luoyx257/smart_fan_stm32/USER_PROTOCOL.md

# 智能小风扇 —— 通信协议与接线规格

本文档是**你配置上位机（TJC 串口屏 / 手机蓝牙 APP / SU-03T 语音模块）的唯一依据**，
单片机侧的解析代码已按本文实现完毕，地址如下：

| 用途 | 文件 |
|---|---|
| 串口屏解析/上报 | `Core/App/Src/app_ui.c` |
| 蓝牙解析 | `Core/App/Src/app_bt.c` |
| 语音解析 | `Core/App/Src/app_voice.c` |
| 命令码汇总 | `Core/App/Inc/cmd.h` |

---

## 0. 接线与串口参数（已核对，与你给的引脚表一致）

| 功能 | STM32 引脚 | 外设 | 波特率 | 备注 |
|---|---|---|---|---|
| 舵机 PWM | PA8 | TIM1_CH1 | 50Hz | 脉宽 500~2500us |
| 语音模块 | PA9 / PA10 | USART1 TX / RX | 9600 | 接 SU-03T 的 RX / TX（交叉） |
| 风扇调速 | PB5 | TIM3_CH2 | 20kHz | TB6612 PWMA |
| OLED | PB6 / PB7 | I2C1 SCL / SDA | 100kHz | SSD1306，地址 0x3C 或 0x3D，代码会自动探测 |
| 蜂鸣器 | PB8 | GPIO 输出 | — | **低电平发声**（MH-FMD 模块） |
| 蓝牙 | PB10 / PB11 | USART3 TX / RX | 9600 | 接 HC-05 的 RX / TX（交叉） |
| 电机方向 | PB0 / PB1 | GPIO 输出 | — | AIN1 / AIN2（正转：PB0=1, PB1=0） |
| 压力传感器 DO | PA5 | GPIO 输入（内部上拉） | — | 数字量判据，阈值用电位器调 |
| 压力传感器 AO | PA4 | ADC1_IN4 | — | 只用于显示原始值 |
| 串口屏 | PA2 / PA3 | USART2 TX / RX | 115200 | 交叉接屏的 RX / TX |
| 温湿度 | PA1 | GPIO 单总线 | — | DHT11，代码会动态切输出/输入 |
| 人体红外 | PA0 | GPIO 输入（内部上拉） | — | HC-SR501，高电平为检测到人 |
| 舵机电源 | — | 独立 5~6V | — | **必须共地**，详见第 5 节 |

---

## 1. 串口屏（TJC4827X243_011C，USART2 @ 115200）

### 1.1 屏幕 → 单片机：命令帧格式

```
'@'  CMD(1 个 ASCII 字符)  [VALUE(十进制数字, 可选)]
```

* 帧尾可以是 `\n`、`\r` 或 `0xFF`，代码三种都认；也支持用 `,` 分隔多个参数。
* 命令字符区分大小写：**0~9 和 A~F 表示功能，大写字母**。

### 1.2 命令码表（在 TJC 上位机里填到按钮的"触摸按下事件"）

| 命令码 | 功能 | 需要带参数 | TJC 里填的代码 |
|---|---|---|---|
| `0` | 打开风扇 | 否 | `printh 40 30 0D 0A` |
| `1` | 关闭风扇 | 否 | `printh 40 31 0D 0A` |
| `2` | 切到**手动**模式 | 否 | `printh 40 32 0D 0A` |
| `3` | 切到**自动**模式 | 否 | `printh 40 33 0D 0A` |
| `4` | 直接设定档位 0~5 | 是 | `printh 40 34 XXXX 0D 0A` |
| `5` | 设定温度阈值 10~45 | 是 | `printh 40 35 XXXX 0D 0A` |
| `6` | 设定倒计时（**秒**，0=取消） | 是 | `printh 40 36 XXXX 0D 0A` |
| `7` | 开始摇头 | 否 | `printh 40 37 0D 0A` |
| `8` | 停止摇头 | 否 | `printh 40 38 0D 0A` |
| `9` | 档位 +1 | 否 | `printh 40 39 0D 0A` |
| `A` | 档位 −1 | 否 | `printh 40 41 0D 0A` |
| `B` | 模式切换 | 否 | `printh 40 42 0D 0A` |
| `C` | 摇头开关切换 | 否 | `printh 40 43 0D 0A` |
| `D` | 风扇开关切换 | 否 | `printh 40 44 0D 0A` |
| `E` | 取消倒计时 | 否 | `printh 40 45 0D 0A` |
| `F` | 请求立即上报一次状态 | 否 | `printh 40 46 0D 0A` |

> `printh` 后面是**十六进制字节**。`40` = `'@'`，`0D 0A` = 回车换行。
> 带参数的（如 `4`/`5`/`6`）用 `printh` 拼四位数字比较麻烦，
> **更推荐用 `prints` + 数字控件组合**，见 1.4 节的示例。

### 1.3 单片机 → 屏幕：控件名约定

代码会写下面这些控件，**你必须在 TJC 工程里建好同名控件**，否则屏上不会变化：

| 控件名 | 类型 | 内容 | 说明 |
|---|---|---|---|
| `t0` | 数字控件 | 当前**温度** ℃ | 无有效读数时显示上一次的值 |
| `t1` | 数字控件 | 当前**湿度** % | |
| `t2` | 文本控件 | 模式 `AUTO` / `MANU` | |
| `t3` | 数字控件 | 当前**档位** 0~5 | |
| `t4` | 数字控件 | 倒计时**剩余秒数** | 未启用时为 0 |
| `t5` | 文本控件 | 摇头 `ON` / `OFF` | |
| `t6` | 数字控件 | 当前**温度阈值** | |
| `t7` | 文本控件 | 风扇 `ON` / `OFF` | |

上报节奏：
* 状态发生变化的 **150ms 后**上报一次关键项；
* 每 **5 秒**做一次整体刷新（含阈值 `t6`）。

### 1.4 TJC 里写"带参数命令"的推荐做法（滑块/数字控件）

假设你放了一个滑块叫 `h0`（范围 0~5，用来调档位），想让"松手"时下发 `@4<数值>`。
TJC 的 `printh` 不能直接插入变量，所以用 `prints` 拼字符串再发：

```
// h0 的"触摸释放事件"
printh 40 34
prints h0.val,0
printh 0D 0A
```

* `printh 40 34` 先发 `'@'` 和 `'4'`
* `prints h0.val,0` 把滑块数值当作**十进制字符串**发出去（`,0` 表示十进制）
* `printh 0D 0A` 发结束符

温度阈值（命令码 `5`）和倒计时（命令码 `6`）同理，把 `34` 换成 `35` / `36` 即可。

> 倒计时注意单位是**秒**。如果你想用分钟输入，就把控件值乘 60 再发，
> 或者告诉我，我把单片机侧改成按分钟解析。

---

## 2. 蓝牙（HC-05，USART3 @ 9600）—— 文本行协议

手机装任意"蓝牙串口助手"（推荐安卓的 *Serial Bluetooth Terminal*），
连上 HC-05 后直接发下面这些**文本命令**，每条以换行结尾。
命令**大小写不敏感**。

| 命令 | 功能 |
|---|---|
| `ON` | 开风扇 |
| `OFF` | 关风扇（同时关摇头、退出倒计时） |
| `AUTO` | 自动模式 |
| `MANUAL` | 手动模式 |
| `MODE` | 模式切换 |
| `L+` / `L-` | 档位 +1 / −1 |
| `LV0` ~ `LV5` | 直接设定档位 |
| `TH20` | 温度阈值设为 20（10~45，超范围自动夹紧） |
| `TIME300` | 倒计时 300 秒（`TIME0` 等于取消） |
| `TCANCEL` | 取消倒计时 |
| `SWING` / `NOSWING` | 摇头开 / 关 |
| `SW` | 摇头切换 |
| `STATUS` | 请求上报一次状态 |

每收到一条命令，单片机都会回一行 `ACK:xxx`；无法识别则回 `ERR`。
**在手机 APP 上看到 `ACK` 就说明接线和波特率都是对的**——这是最方便的联调手段。

> 如果你打算自己写安卓 APP，也可以直接照抄这个文本协议，很省事。

---

## 3. 语音（SU-03T，USART1 @ 9600）—— 二进制帧协议

### 3.1 帧格式（固定 5 字节）

```
0xAA  0x55  CMD  VALUE  XOR
```

| 字节 | 含义 |
|---|---|
| `0xAA` | 帧头 1 |
| `0x55` | 帧头 2 |
| `CMD` | 命令码，见 3.2 表 |
| `VALUE` | 参数；不需要参数的填 `0x00` |
| `XOR` | 前 4 字节异或校验：`0xAA ^ 0x55 ^ CMD ^ VALUE` |

示例：`打开风扇` = `AA 55 01 00 FE`
计算：`AA ^ 55 = FF`，`FF ^ 01 = FE`，`FE ^ 00 = FE` ✔

### 3.2 命令码表（在 SU-03T 的词条里逐条填"串口输出"）

| CMD | 功能 | VALUE | 完整帧（十六进制） |
|---|---|---|---|
| `0x01` | 打开风扇 | 0 | `AA 55 01 00 FE` |
| `0x02` | 关闭风扇 | 0 | `AA 55 02 00 FD` |
| `0x03` | 自动模式 | 0 | `AA 55 03 00 FC` |
| `0x04` | 手动模式 | 0 | `AA 55 04 00 FB` |
| `0x05` | 切换模式 | 0 | `AA 55 05 00 FA` |
| `0x06` | 调高一档 | 0 | `AA 55 06 00 F9` |
| `0x07` | 调低一档 | 0 | `AA 55 07 00 F8` |
| `0x08` | 设置到第 N 档 | N (0~5) | `AA 55 08 N (FD^N)` |
| `0x09` | 温度阈值设为 N | N (10~45) | `AA 55 09 N (FC^N)` |
| `0x0A` | 阈值 +1 | 0 | `AA 55 0A 00 F5` |
| `0x0B` | 阈值 −1 | 0 | `AA 55 0B 00 F4` |
| `0x0C` | 倒计时 N **分钟** | N | `AA 55 0C N (F3^N)` |
| `0x0D` | 取消倒计时 | 0 | `AA 55 0D 00 F2` |
| `0x0E` | 开始摇头 | 0 | `AA 55 0E 00 F1` |
| `0x0F` | 停止摇头 | 0 | `AA 55 0F 00 F0` |
| `0x10` | 摇头切换 | 0 | `AA 55 10 00 EF` |
| `0x11` | 上报当前状态 | 0 | `AA 55 11 00 EE` |
| `0x12` | 查询是否正在恒温调速 | 0 | `AA 55 12 00 ED` |

### 3.3 建议的 17 个词条（照着录就行）

```
小风扇打开 / 打开风扇      -> AA 55 01 00 FE
小风扇关闭 / 关闭风扇      -> AA 55 02 00 FD
自动模式                   -> AA 55 03 00 FC
手动模式                   -> AA 55 04 00 FB
切换模式                   -> AA 55 05 00 FA
调高一档 / 风大一点        -> AA 55 06 00 F9
调低一档 / 风小一点        -> AA 55 07 00 F8
设置到一档                 -> AA 55 08 01 FD
设置到三档                 -> AA 55 08 03 FF
设置到五档                 -> AA 55 08 05 F9
温度阈值二十五度            -> AA 55 09 19 E5      (0xFC^0x19 = 0xE5)
温度阈值三十度              -> AA 55 09 1E E2
阈值高一点                 -> AA 55 0A 00 F5
阈值低一点                 -> AA 55 0B 00 F4
倒计时十分钟               -> AA 55 0C 0A F9      (0xF3^0x0A = 0xF9)
开始摇头                   -> AA 55 0E 00 F1
停止摇头                   -> AA 55 0F 00 F0
```

> 语音模块到货后如果它的输出格式跟这里不一样（比如只能输出固定字符串），
> 把实际输出格式发我，我改 `app_voice.c` 的解析部分就行，其它都不用动。

---

## 4. 各模式行为约定（和你要的完全对齐）

### 4.1 手动模式
* 风扇开关、档位完全听串口屏 / 蓝牙 / 语音的。
* 档位 1~5 对应占空比 **40% / 55% / 70% / 85% / 100%**。
* 档位到 5 后再按"+"保持 5，不循环。
* 0 档即停止。

### 4.2 自动模式（含增量式 PID 恒温调速）

**开风扇条件**：`(人体红外有人 或 压力传感器判定坐下)` **且** `当前温度 > 阈值`
→ 风扇从 1 档起步，启动 **PID 恒温调速**，并开始蜂鸣报警。

**PID 恒温调速**：

| 项目 | 取值 | 说明 |
|---|---|---|
| 算法 | **增量式 PID** | Δu = Kp·(e[k]−e[k−1]) + Ki·e[k] + Kd·(e[k]−2e[k−1]+e[k−2]) |
| 设定值 | 当前温度阈值（`t6` / `TH` 可调） | 阈值既是启动条件，也是控制目标 |
| 被控量 | DHT11 温度 | 采样周期 2s（DHT11 硬件上限） |
| 输出 | 风扇档位 1~5 | 限幅在 1~5，PID 不负责关机 |
| 运算周期 | **10s** | 温控对象时间常数在分钟级，取 1/10~1/5 |
| Kp / Ki / Kd | 0.30 / 0.12 / 0.04 | 见 `app_state.h` 的 `PID_KP` 等宏 |
| 死区 | **±0.5℃** | DHT11 只有 1℃ 分辨率，无死区会稳态抖动 |
| 积分为何不饱和 | 增量式结构天然抗饱和 | 积分作用体现在已限幅的 u[k−1] 上 |

**为什么用增量式而不是位置式**（面试常问）：
1. 温控是大惯性对象，增量式输出"增量"，不会因积分瞬间累积把执行器一次打到极限；
2. 执行器是离散档位（1~5），增量式天然适合；
3. 不需要保存历史积分项，RAM 开销小，也不需要额外的抗饱和逻辑。

**⚠️ 传感器位置要求**：DHT11 **必须远离风扇出风口**。
PID 要求负反馈——测的必须是环境温度。若 DHT11 在风口，风扇一转测到的温度反而更低，
PID 会判断"还不够冷"而继续加档，最后饱和到 5 档并永远收敛不了。
这是**正反馈**导致的，不是代码问题。

**关风扇条件**（任一满足）：
1. 人离开（红外无人 **且** 压力无）**持续 30 秒**；
2. 温度降到 `阈值 − 2℃` 以下（2℃ 回差，避免临界点反复开关）。
→ 关闭时同时退出 PID，并复位 PID 历史误差（下次进入不会带旧数据）。

**其它保护**：
* DHT11 读数失败时**不会**因为"温度=0"误关风扇，也不会让 PID 瞎调；
* 自动模式下人工按"档位 +/−"（或发 `LVn`）会**把 PID 输出对齐到该档位**，
  避免下一次 PID 运算又把它跳回去；
* 切模式 / 关风扇会复位 PID 状态。

### 4.3 蜂鸣器报警
* 只在自动模式且风扇在转时报警。
* 节奏：**响 200ms → 停 1.8s** 循环。
* 报警累计 **30 秒后自动静音**（不会一直吵）。

### 4.4 倒计时
* 时间到：**关风扇 + 关摇头 + 舵机回中位**（按你的要求"都关"）。
* 手动关风扇也会同时取消倒计时，避免出现"风扇停了但倒计时还在跑"。
* 设置倒计时会自动把风扇开起来。

### 4.5 摇头
* 非阻塞状态机，不影响其它功能：
  `左 45°（停 1.2s）→ 中位（停 0.3s）→ 右 225°（停 1.2s）→ 中位 → 循环`
* 关闭摇头时舵机回中位。

---

## 5. 硬件必须注意的 3 件事

### 5.1 舵机必须独立供电 ★最重要
维特 P20 舵机堵转电流 **1.0~2.3A**，空载 0.3~0.8A。
STM32 蓝板的 5V 引脚来自 USB，整口只有 500mA，**绝对带不动**。

* 舵机 VCC 接**独立 5~6V 电源**（≥3A 最稳，2A 也能凑合）；
* 舵机 GND **必须和单片机 GND 共地**；
* 舵机信号线接 PA8 直连即可（信号电流很小，共地后没问题）。

不这么接的典型现象：舵机一动 → 5V 掉压 → 单片机复位 / OLED 花屏 / 蓝牙掉线。

### 5.2 DHT11 上拉
你买的是三脚集成模块，模块自带上拉电阻，直接接 PA1 / 5V / GND 就行。
如果读不到数据，先量一下 DATA 对 VCC 之间是否有 4.7k~10k 电阻。

### 5.3 压力传感器方向
代码默认 **DO 输出高电平 = 判定坐下**。
如果你的模块是低电平有效（坐下时 DO 变低），告诉我一声，改一行就行
（`Core/Bsp/Src/bsp_sensor.c` 的 `Sensor_PressureDoActive()`）。

---

## 6. 怎么快速判断有没有跑起来

按这个顺序测，每步都有明确的"成功现象"：

| 步骤 | 操作 | 成功现象 | 失败说明 |
|---|---|---|---|
| 1 | 上电 | OLED 显示 4 行内容 | 全黑 → OLED 地址/接线问题（代码会自动试 0x3C 和 0x3D） |
| 2 | 手机连 HC-05，发 `STATUS` | 收到 `ACK:STATUS` | 没回复 → 检查 USART3 交叉接线和 9600 波特率 |
| 3 | 发 `ON` 然后 `L+` | 风扇转起来，档位递增，OLED 档位跟着变 | 只转不调速 → PWMA/PB5 接线 |
| 4 | 发 `SWING` | 舵机开始左右摆头 | 不动 → 先查舵机独立电源和共地，再看 PA8 |
| 5 | 发 `AUTO`，用手靠近红外 | 风扇开 + 蜂鸣器滴滴响 | 不响应 → 红外模块需 1 分钟预热，属正常 |
| 6 | 串口屏上点按钮 | 屏上数值实时更新 | 不动 → 核对 1.3 节的控件名是否一致 |
| 7 | 发 `TIME10` | 屏/OLED 显示倒计时递减，到点全关 | — |

---

## 7. 代码结构（方便你自己改）

```
Core/
├── App/
│   ├── Inc/  app_state.h cmd.h app_fan.h app_sensor.h app_oled.h app_ui.h app_bt.h app_voice.h
│   └── Src/  app_state.c cmd.c app_fan.c app_sensor.c app_oled.c app_ui.c app_bt.c app_voice.c
├── Bsp/
│   ├── Inc/  bsp_delay.h bsp_dht11.h bsp_sensor.h bsp_fan.h bsp_servo.h bsp_buzzer.h bsp_pid.h
│   │         oled_font.h bsp_oled.h bsp_uart.h bsp_screen.h
│   └── Src/  bsp_delay.c bsp_dht11.c bsp_sensor.c bsp_fan.c bsp_servo.c bsp_buzzer.c bsp_pid.c
│             oled_font.c bsp_oled.c bsp_uart.c bsp_screen.c
└── Src/      freertos.c（已改成调用 App 层任务函数）
```

需要调参数全在 **`Core/App/Inc/app_state.h`** 顶部的宏里（阈值、档位映射、
摇头角度、报警节奏、去抖时间等），改完重新编译即可。

---

## 8. 当前资源占用（已实测编译）

```
Program Size: Code=28796  RO-data=3864  RW-data=272  ZI-data=15400
```

| 项目 | 占用 | 上限 | 余量 |
|---|---|---|---|
| Flash | 32932 B | 65536 B | 50.3% |
| RAM | 15672 B | 20480 B | 23.5%（还有 4.8KB） |

其中 FreeRTOS 堆已从 CubeMX 默认的 3072 B 调到 **8192 B**
（原值会让任务创建失败并卡死在 `configASSERT`，这是个必踩的坑）。
