luoyx257/smart_fan_stm32/hardware/BOM_Board1_PCB1_2026-09-28.xlsx

No. | Quantity | Comment | Designator | Footprint | Value | Manufacturer Part | Manufacturer | Supplier Part | Supplier
1 | 1 | 10nF | C1 | C0603 | 10nF | FCC0603B103K500CT | FOJAN(富捷) | C5137477 | LCSC
2 | 1 | 22uF | C2 | CAP-TH_BD10.0-P5.00-D0.6-FD | 22uF | PA160V22M10X13 | JIERR(捷而瑞) | C48935343 | LCSC
3 | 1 | 3.9nF | C3 | C0805 | 3.9nF | GRM2165C1H392JA01D | muRata(村田) | C97901 | LCSC
4 | 1 | 100nF | C4 | C0603 | 100nF | FCC0603B104K500CT | FOJAN(富捷) | C5137636 | LCSC
5 | 1 | 10uF | C5 | CAP-SMD_BD5.0-L5.3-W5.3-LS6.0-FD | 10uF | JVJ50v10M5x5 | JIERR(捷而瑞) | C46550416 | LCSC
6 | 1 | HX PM2.54-1x7P ZC-Y | CN1 | HDR-TH_7P-P2.54-V-F |  | HX PM2.54-1x7P ZC-Y | hanxia(韩下) | C22438157 | LCSC
7 | 2 | LAIL-PTB3.81-2P-GN-02S-ZC | CN2,CN3 | CONN-TH_LAIL-PTB3.81-2P-GN-02S-ZC |  | LAIL-PTB3.81-2P-GN-02S-ZC | LAILAN(莱联) | C55144765 | LCSC
8 | 1 | PH2.0-4P | CN4 | CONN-TH_PH2.0-4P |  | PH2.0-4P | CAX(创都) | C722763 | LCSC
9 | 1 | HX PZ2.54-1x3P ZZ | H1 | CONN-TH_HX-PZ2.54-1X3P-ZZ |  | HX PZ2.54-1x3P ZZ | hanxia(韩下) | C32713269 | LCSC
10 | 1 | 2.54-1*4P母 | H2 | HDR-TH_4P-P2.54-V-F |  | 2.54-1*4P母 | BOOMELE(博穆精密) | C2718488 | LCSC
11 | 1 | 10uH | L2 | IND-SMD_L6.0-W6.0_LPS6225 | 10uH | PNR6045-100-M | JIERR(捷而瑞) | C55381773 | LCSC
12 | 1 | MHL4230LRTD | LED1 | LED-TH_BD4.8-P2.54-FD_RED |  | MHL4230LRTD | MEIHUA(美华) | C7470871 | LCSC
13 | 2 | 2.54-1*8P母环保 | P1,P2 | HDR-TH_8P-P2.54-V-F |  | 2.54-1*8P母环保 | BOOMELE(博穆精密) | C27438 | LCSC
14 | 1 | 2.54-1*6P母 | P3 | HDR-TH_6P-P2.54-V-F |  | 2.54-1*6P母 | BOOMELE(博穆精密) | C40877 | LCSC
15 | 1 | AO3401 | Q1 | SOT-23-3_L2.9-W1.4-P1.90-LS2.6-BR |  | AO3401 | TWGMC(迪嘉) | C727156 | LCSC
16 | 1 | 44.2kΩ | R1 | R0402 | 44.2kΩ | FRC0402F4422TS | FOJAN(富捷) | C2933098 | LCSC
17 | 1 | 10kΩ | R3 | R0805 | 10kΩ | RT0805BRD0710KL | YAGEO(国巨) | C110775 | LCSC
18 | 1 | 1kΩ | R4 | R0805 | 1kΩ | RT0805BRD071KL | YAGEO(国巨) | C110774 | LCSC
19 | 1 | 150Ω | R5 | RES-TH_BD4.5-L11.5-P15.50-D0.8 | 150Ω | MFR2WSFTE73-150R | YAGEO(国巨) | C173070 | LCSC
20 | 1 | 10kΩ | R6 | R0402 | 10kΩ | FRC0402F1002TS | FOJAN(富捷) | C2906861 | LCSC
21 | 1 | 100kΩ | R7 | R0402 | 100kΩ | FRC0402F1003TS | FOJAN(富捷) | C2906859 | LCSC
22 | 2 | KH-2.54FH-1X20P-H8.5 | U1,U2 | HDR-TH_20P-P2.54-V-F-2 |  | KH-2.54FH-1X20P-H8.5 | kinghelm(金航标) | C2905423 | LCSC
23 | 2 | KH-2.54FH-1X11P-H8.5 | U3,U4 | HDR-TH_11P-P2.54-V-F |  | KH-2.54FH-1X11P-H8.5 | kinghelm(金航标) | C2932674 | LCSC
24 | 1 | DHT11 | U5 | SENSOR-TH_DHT11 |  | DHT11 | 广州奥松 | C117051 | LCSC
25 | 3 | PM2.54-1*3 | U6,U7,U9 | HDR-TH_3P-P2.54-V-F |  | PM2.54-1*3 | ZHOURI(洲日) | C5116529 | LCSC
26 | 1 | MSMP2307DN-LF-Z | U8 | ESOP-8_L4.9-W3.9-P1.27-LS6.0-BL-EP |  | MSMP2307DN-LF-Z | MSKSEMI(美森科) | C49375228 | LCSC
