luoyx257/smart_fan_stm32/MDK-ARM/build_log.txt

*** Using Compiler 'V5.06 update 5 (build 528)', folder: 'D:\keil5\ARM\ARMCC\Bin'
Build target 'smart_fan'
assembling startup_stm32f103xb.s...
compiling i2c.c...
compiling gpio.c...
compiling main.c...
compiling stm32f1xx_it.c...
compiling freertos.c...
compiling usart.c...
compiling tim.c...
compiling adc.c...
compiling stm32f1xx_hal_gpio_ex.c...
compiling stm32f1xx_hal_timebase_tim.c...
compiling stm32f1xx_hal_msp.c...
compiling stm32f1xx_hal_tim_ex.c...
compiling stm32f1xx_hal_tim.c...
compiling stm32f1xx_hal_adc.c...
compiling stm32f1xx_hal_adc_ex.c...
compiling stm32f1xx_hal_cortex.c...
compiling stm32f1xx_hal_dma.c...
compiling stm32f1xx_hal_rcc_ex.c...
compiling stm32f1xx_hal_rcc.c...
compiling stm32f1xx_hal_flash.c...
compiling stm32f1xx_hal_exti.c...
compiling stm32f1xx_hal_pwr.c...
compiling stm32f1xx_hal.c...
compiling list.c...
compiling croutine.c...
compiling stm32f1xx_hal_gpio.c...
compiling event_groups.c...
compiling stm32f1xx_hal_flash_ex.c...
compiling stream_buffer.c...
compiling queue.c...
compiling timers.c...
compiling heap_4.c...
compiling tasks.c...
compiling app_state.c...
compiling cmd.c...
compiling app_sensor.c...
compiling app_fan.c...
compiling port.c...
compiling app_ui.c...
compiling app_oled.c...
compiling system_stm32f1xx.c...
compiling stm32f1xx_hal_uart.c...
compiling app_voice.c...
compiling oled_font.c...
compiling stm32f1xx_hal_i2c.c...
compiling bsp_pid.c...
compiling bsp_fan.c...
compiling bsp_delay.c...
compiling bsp_dht11.c...
compiling cmsis_os2.c...
compiling bsp_servo.c...
compiling app_bt.c...
compiling bsp_oled.c...
compiling bsp_sensor.c...
compiling bsp_buzzer.c...
compiling bsp_screen.c...
compiling bsp_uart.c...
linking...
Program Size: Code=28796 RO-data=3864 RW-data=272 ZI-data=15400  
FromELF: creating hex file...
"smart_fan\smart_fan.axf" - 0 Error(s), 0 Warning(s).
Build Time Elapsed:  00:00:08
