luoyx257/smart_fan_stm32/hardware/pdf.pdf

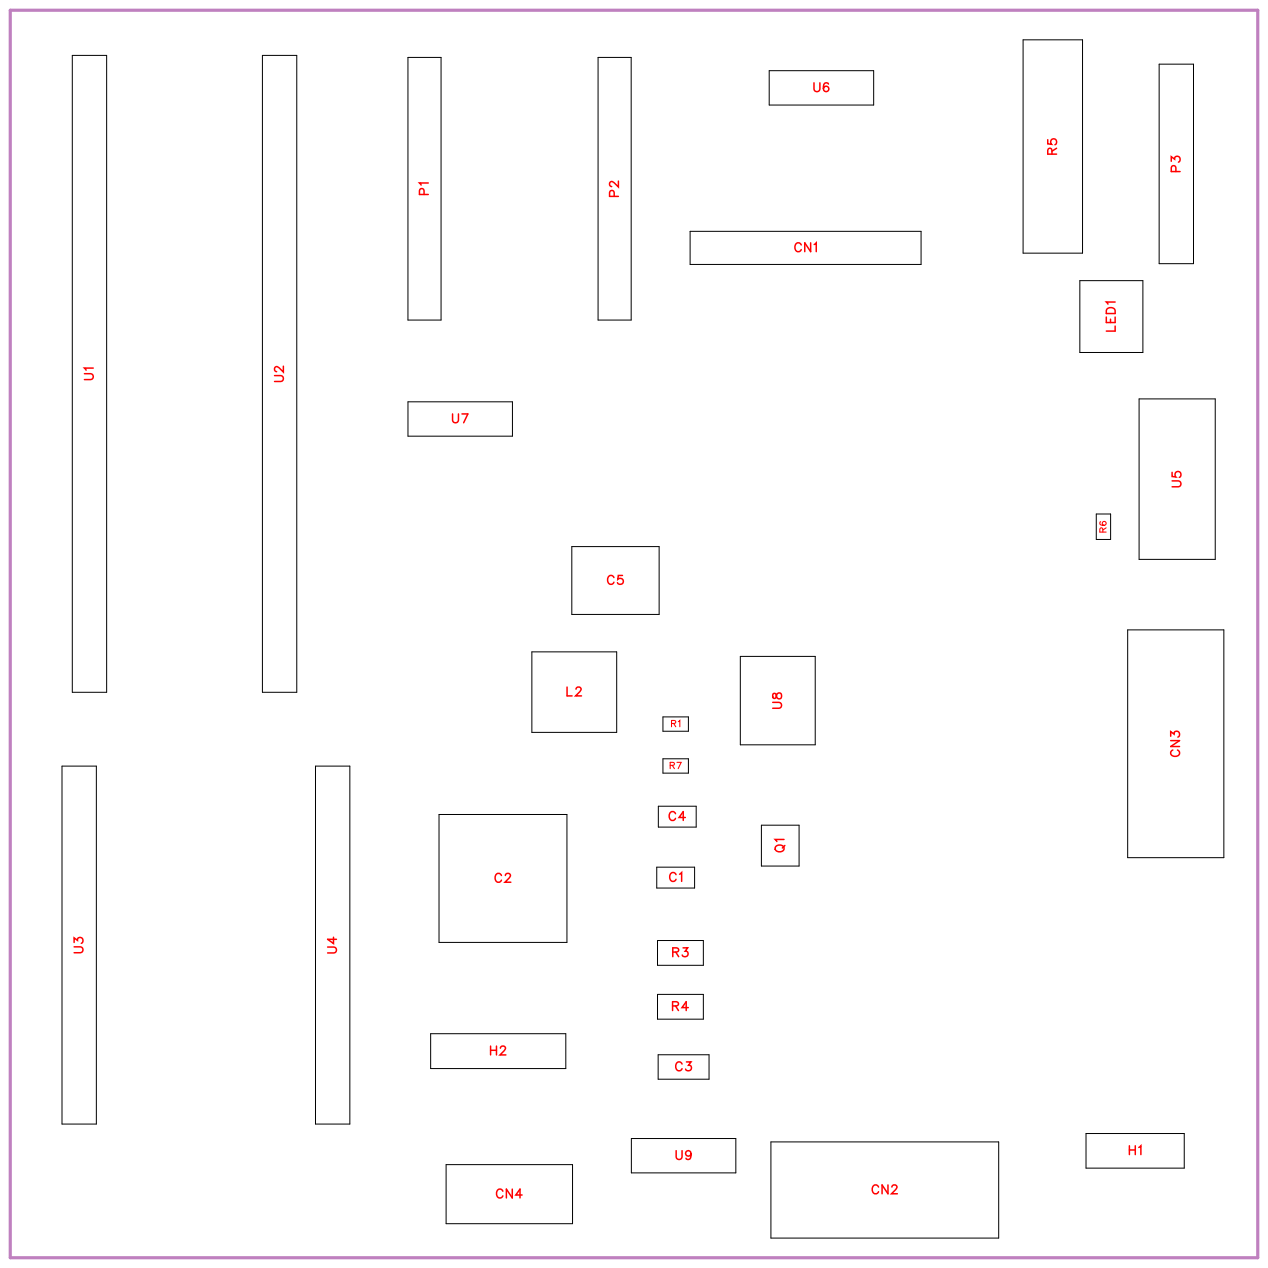
[picture p1: page 1]

No. | Quantity | Comment | Designator | Footprint | Value | Manufacture r Part | Manufacture r | Supplier Part | Supplier
1 | 1 | 10nF | C1 | C0603 | 10nF | FCC0603B103 K500CT | FOJAN(Ìw) | C5137477 | LCSC
2 | 1 | 22uF | C2 | CAP-TH_BD10 .0-P5.00-D0 .6-FD | 22uF | PA160V22M10 X13 | JIERR(w^) | C48935343 | LCSC
3 | 1 | 3.9nF | C3 | C0805 | 3.9nF | GRM2165C1H3 92JA01D | muRata(Q0) | C97901 | LCSC
4 | 1 | 100nF | C4 | C0603 | 100nF | FCC0603B104 K500CT | FOJAN(Ìw) | C5137636 | LCSC
5 | 1 | 10uF | C5 | CAP-SMD_BD5 .0-L5.3-W5. 3-LS6.0-FD | 10uF | JVJ50v10M5x 5 | JIERR(w^) | C46550416 | LCSC
6 | 1 | HX PM2.54-1x7P ZC-Y | CN1 | HDR-TH_7P-P 2.54-V-F | | HX PM2.54-1x7P ZC-Y | hanxia(é) | C22438157 | LCSC
7 | 2 | LAIL-PTB3.8 1-2P-GN-02S -ZC | CN2,CN3 | CONN-TH_LAI L-PTB3.81-2 P-GN-02S-ZC | | LAIL-PTB3.8 1-2P-GN-02S -ZC | LAILAN(±T) | C55144765 | LCSC
8 | 1 | PH2.0-4P | CN4 | CONN-TH_PH2 .0-4P | | PH2.0-4P | CAX(ý) | C722763 | LCSC
9 | 1 | HX PZ2.54-1x3P ZZ | H1 | CONN-TH_HX-PZ2.54-1X3P -ZZ | | HX PZ2.54-1x3P ZZ | hanxia(é) | C32713269 | LCSC
10 | 1 | 2.54-1*4PÍ | H2 | HDR-TH_4P-P 2.54-V-F | | 2.54-1*4PÍ | BOOMELE(ZF¾) Tj | T* (Æ) C2718488 | LCSC
11 | 1 | 10uH | L2 | IND-SMD_L6. 0-W6.0_LPS6 225 | 10uH | PNR6045-100 -M | JIERR(w^) | C55381773 | LCSC
12 | 1 | MHL4230LRTDLED1 | | LED-TH_BD4. 8-P2.54-FD_ RED | | MHL4230LRTDMEIHUA(ŽN) | | C7470871 | LCSC
13 | 2 | 2.54-1*8PÍ¯ Ý | P1,P2 | HDR-TH_8P-P 2.54-V-F | | 2.54-1*8PÍ¯ Ý | BOOMELE(ZF¾) Tj | T* (Æ) C27438 | LCSC
14 | 1 | 2.54-1*6PÍ | P3 | HDR-TH_6P-P 2.54-V-F | | 2.54-1*6PÍ | BOOMELE(ZF¾) Tj | T* (Æ) C40877 | LCSC
15 | 1 | AO3401 | Q1 | SOT-23-3_L2 .9-W1.4-P1. 90-LS2.6-BR | | AO3401 | TWGMC(ê ) | C727156 | LCSC
16 | 1 | 44.2k© | R1 | R0402 | 44.2k© | FRC0402F442 2TS | FOJAN(Ìw) | C2933098 | LCSC
17 | 1 | 10k© | R3 | R0805 | 10k© | RT0805BRD07 10KL | YAGEO(ýè) | C110775 | LCSC
18 | 1 | 1k© | R4 | R0805 | 1k© | RT0805BRD07 1KL | YAGEO(ýè) | C110774 | LCSC
19 | 1 | 150© | R5 | RES-TH_BD4. 5-L11.5-P15 .50-D0.8 | 150© | MFR2WSFTE73 -150R | YAGEO(ýè) | C173070 | LCSC

20 | 1 | 10k© | R6 | R0402 | 10k© | FRC0402F100 2TS | FOJAN(Ìw) | C2906861 | LCSC
21 | 1 | 100k© | R7 | R0402 | 100k© | FRC0402F100 3TS | FOJAN(Ìw) | C2906859 | LCSC
22 | 2 | KH-2.54FH-1 X20P-H8.5 | U1,U2 | HDR-TH_20P-P2.54-V-F-2 | | KH-2.54FH-1 X20P-H8.5 | kinghelm(Ñ*) Tj | T* () C2905423 | LCSC
23 | 2 | KH-2.54FH-1 X11P-H8.5 | U3,U4 | HDR-TH_11P-P2.54-V-F | | KH-2.54FH-1 X11P-H8.5 | kinghelm(Ñ*) Tj | T* () C2932674 | LCSC
24 | 1 | DHT11 | U5 | SENSOR-TH_D HT11 | | DHT11 | •Þe~ | C117051 | LCSC
25 | 3 | PM2.54-1*3 | U6,U7,U9 | HDR-TH_3P-P 2.54-V-F | | PM2.54-1*3 | ZHOURI(2å) | C5116529 | LCSC
26 | 1 | MSMP2307DN-LF-Z | U8 | ESOP-8_L4.9 -W3.9-P1.27 -LS6.0-BL-E P | | MSMP2307DN-LF-Z | MSKSEMI(ŽîÑ) Tj | T* () C49375228 | LCSC

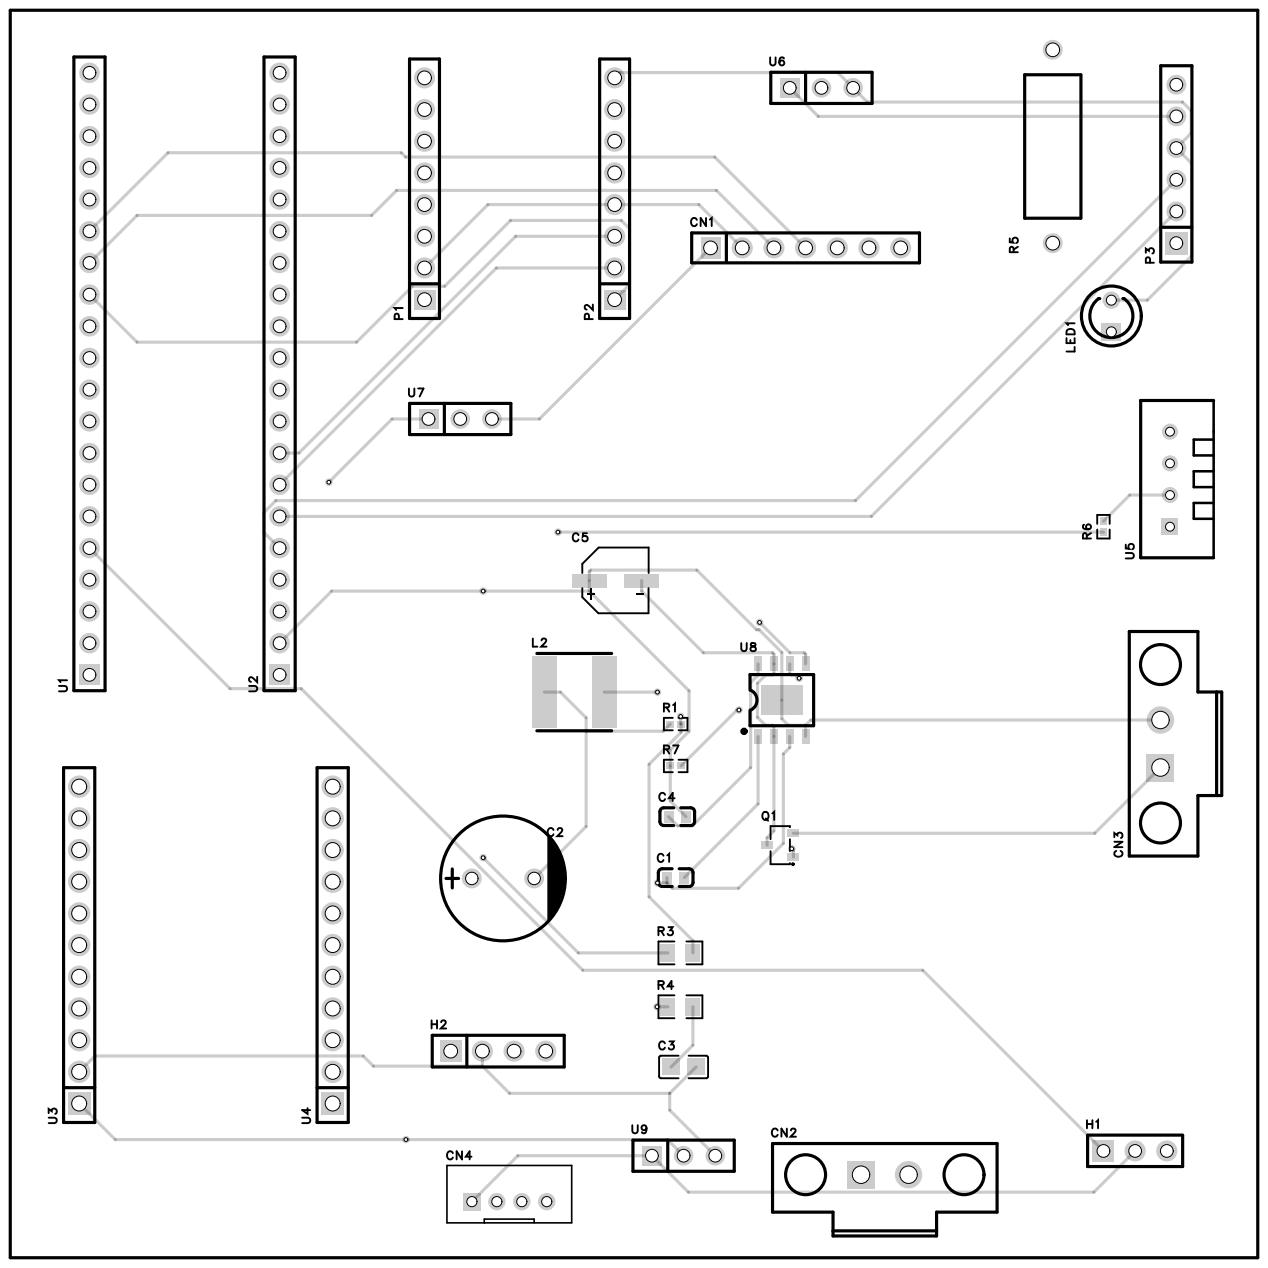
[picture p2: page 5]

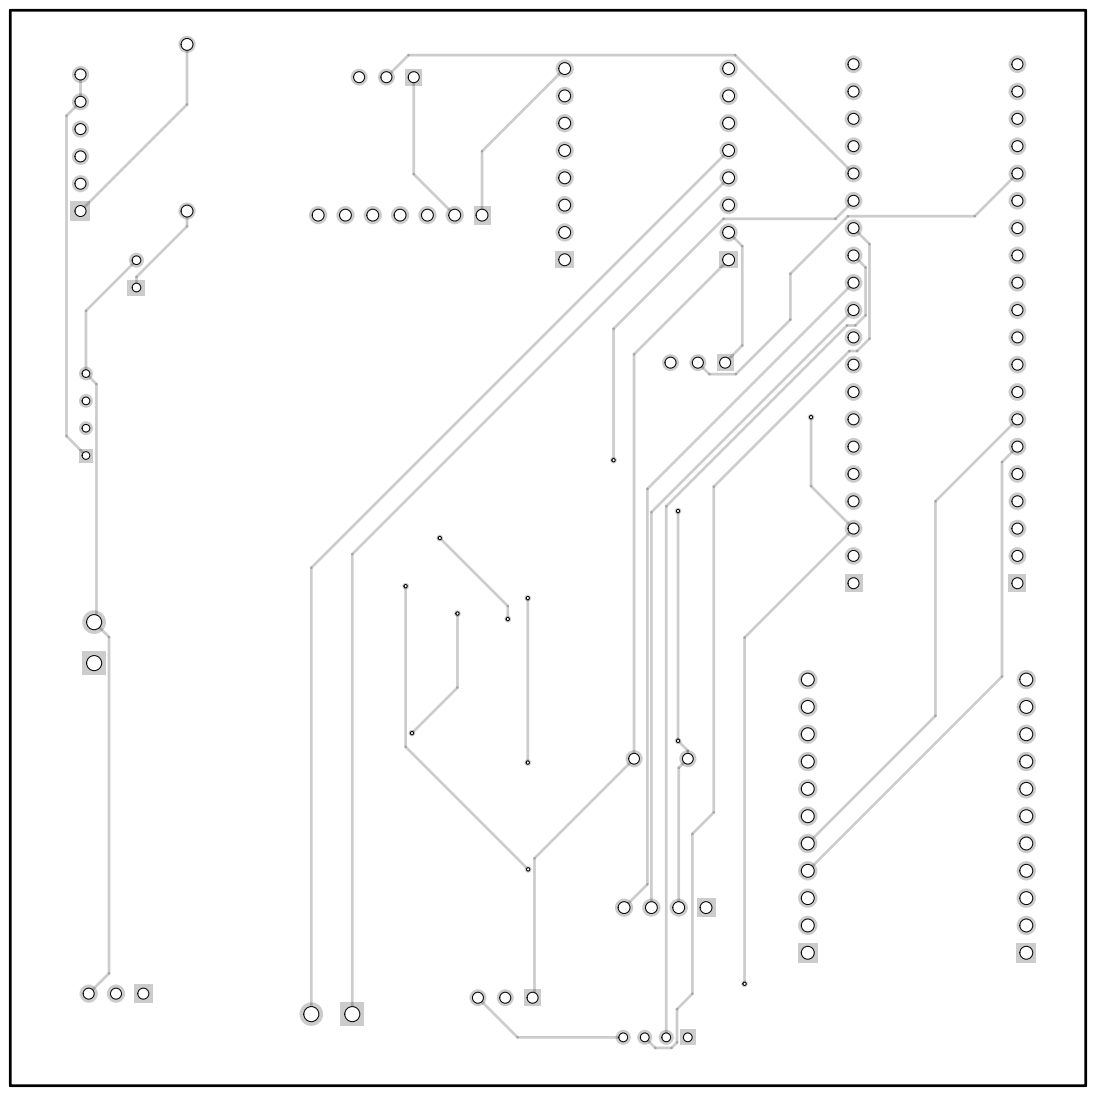
[picture p3: page 6]

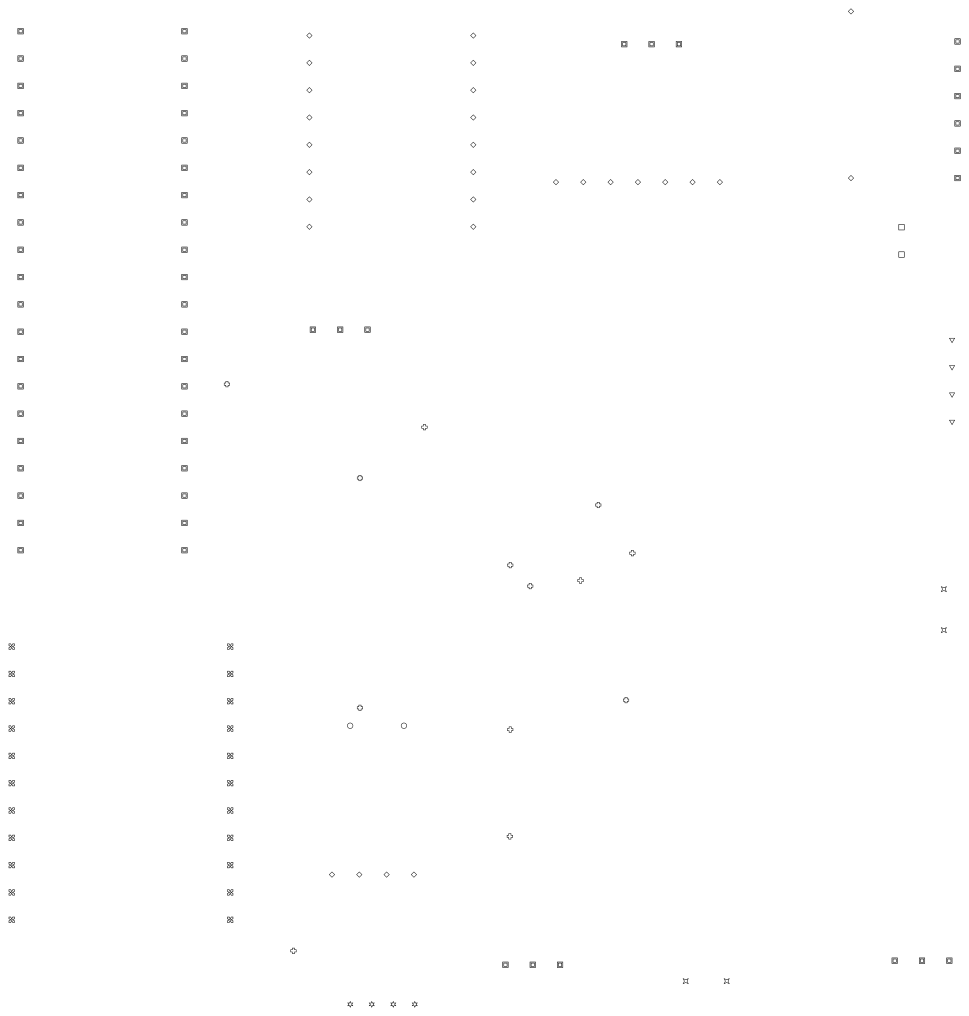
[picture p4: page 7]
