luoyx257/smart_fan_stm32/smart_fan.ioc

Mcu.UserName=STM32F103C8Tx
PA0-WKUP.Signal=GPIO_Input
PA1.Signal=GPIO_Input
PA10.Signal=USART1_RX
PA13.Signal=SYS_JTMS-SWDIO
PA14.Signal=SYS_JTCK-SWCLK
PA2.Signal=USART2_TX
PA3.Signal=USART2_RX
PA4.Signal=ADCx_IN4
PA5.Signal=GPIO_Input
PA8.Signal=S_TIM1_CH1
PA9.Signal=USART1_TX
PB0.Signal=GPIO_Output
PB1.Signal=GPIO_Output
PB10.Signal=USART3_TX
PB11.Signal=USART3_RX
PB5.Signal=S_TIM3_CH2
PB6.Signal=I2C1_SCL
PB7.Signal=I2C1_SDA
PB8.Signal=GPIO_Output
PD0-OSC_IN.Signal=RCC_OSC_IN
PD1-OSC_OUT.Signal=RCC_OSC_OUT
