luoyx257/smart_fan_stm32/Core/Bsp/Src/oled_font.c

/**
  ******************************************************************************
  * @file    oled_font.c
  * @brief   8x16 ASCII 点阵字库（字符 0x20~0x7E，共 95 个）
  * @note    点阵排列与 SSD1306 显存一致：每列 1 字节，低位在上（bit0 = 页内最上一行）。
  *          每个字符 16 列 x 2 页 = 32 字节：前 16 字节为上半（行 0~7），
  *          后 16 字节为下半（行 8~15）。
  *          本文件由工具自动生成，如需更换字体请重新生成，不要手改。
  ******************************************************************************
  */

/* Includes ------------------------------------------------------------------*/
#include "oled_font.h"

/* Private variables ---------------------------------------------------------*/
/* 字符 0x20（空格）到 0x7E（~）的 8x16 点阵 */
const uint8_t OLED_Font8x16[OLED_FONT_CHARS][OLED_FONT_BYTES_PER_CHAR] = {
    { 0x00,0x00,0x00,0x00,0x00,0x00,0x00,0x00,0x00,0x00,0x00,0x00,0x00,0x00,0x00,0x00 },   /* 0x20 */
    { 0x00,0x00,0x00,0x00,0x00,0xFE,0xFE,0x00,0x00,0x00,0x00,0x00,0x00,0x06,0x06,0x00 },   /* 0x21 */
    { 0x00,0x00,0x00,0x00,0x0E,0x02,0x00,0x0E,0x00,0x00,0x00,0x00,0x00,0x00,0x00,0x00 },   /* 0x22 */
    { 0x00,0x00,0x80,0x90,0xF8,0x9C,0x90,0xFC,0x00,0x00,0x00,0x00,0x07,0x00,0x06,0x07 },   /* 0x23 */
    { 0x00,0x00,0x00,0x38,0x3C,0xE4,0xFE,0xC4,0x00,0x00,0x00,0x04,0x04,0x1F,0x04,0x06 },   /* 0x24 */
    { 0x00,0x00,0x00,0x1E,0x12,0xDE,0x30,0x98,0x00,0x00,0x00,0x06,0x01,0x00,0x03,0x04 },   /* 0x25 */
    { 0x00,0x00,0x00,0xC8,0x7E,0x62,0x92,0x1C,0x00,0x00,0x00,0x03,0x04,0x04,0x05,0x03 },   /* 0x26 */
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
    { 0x00,0x00,0x00,0x00,0xFC,0x44,0x44,0x44,0x00,0x00,0x00,0x00,0x07,0x00,0x00,0x00 },   /* 0x46 */
    { 0x00,0x00,0x00,0xF0,0x08,0x04,0x44,0x44,0x00,0x00,0x00,0x03,0x06,0x04,0x04,0x04 },   /* 0x47 */
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
};

/*** end of file ***/
