luoyx257/smart_fan_stm32/(commit log)

2026-09-28 feat: add full stm32 source code
2026-09-28 add pcb updated
    [BOM_Board1_PCB1_2026-09-28.xlsx]
